ewsandor/esplant/README.md

# ESPlant

Ed Sandor's Plant Monitor based on an ESP 32 processor
