ewsandor/esplant/pcb/ESPlant.kicad_pcb

## KiCad design pcb/ESPlant.kicad_pcb (2020-08-11)

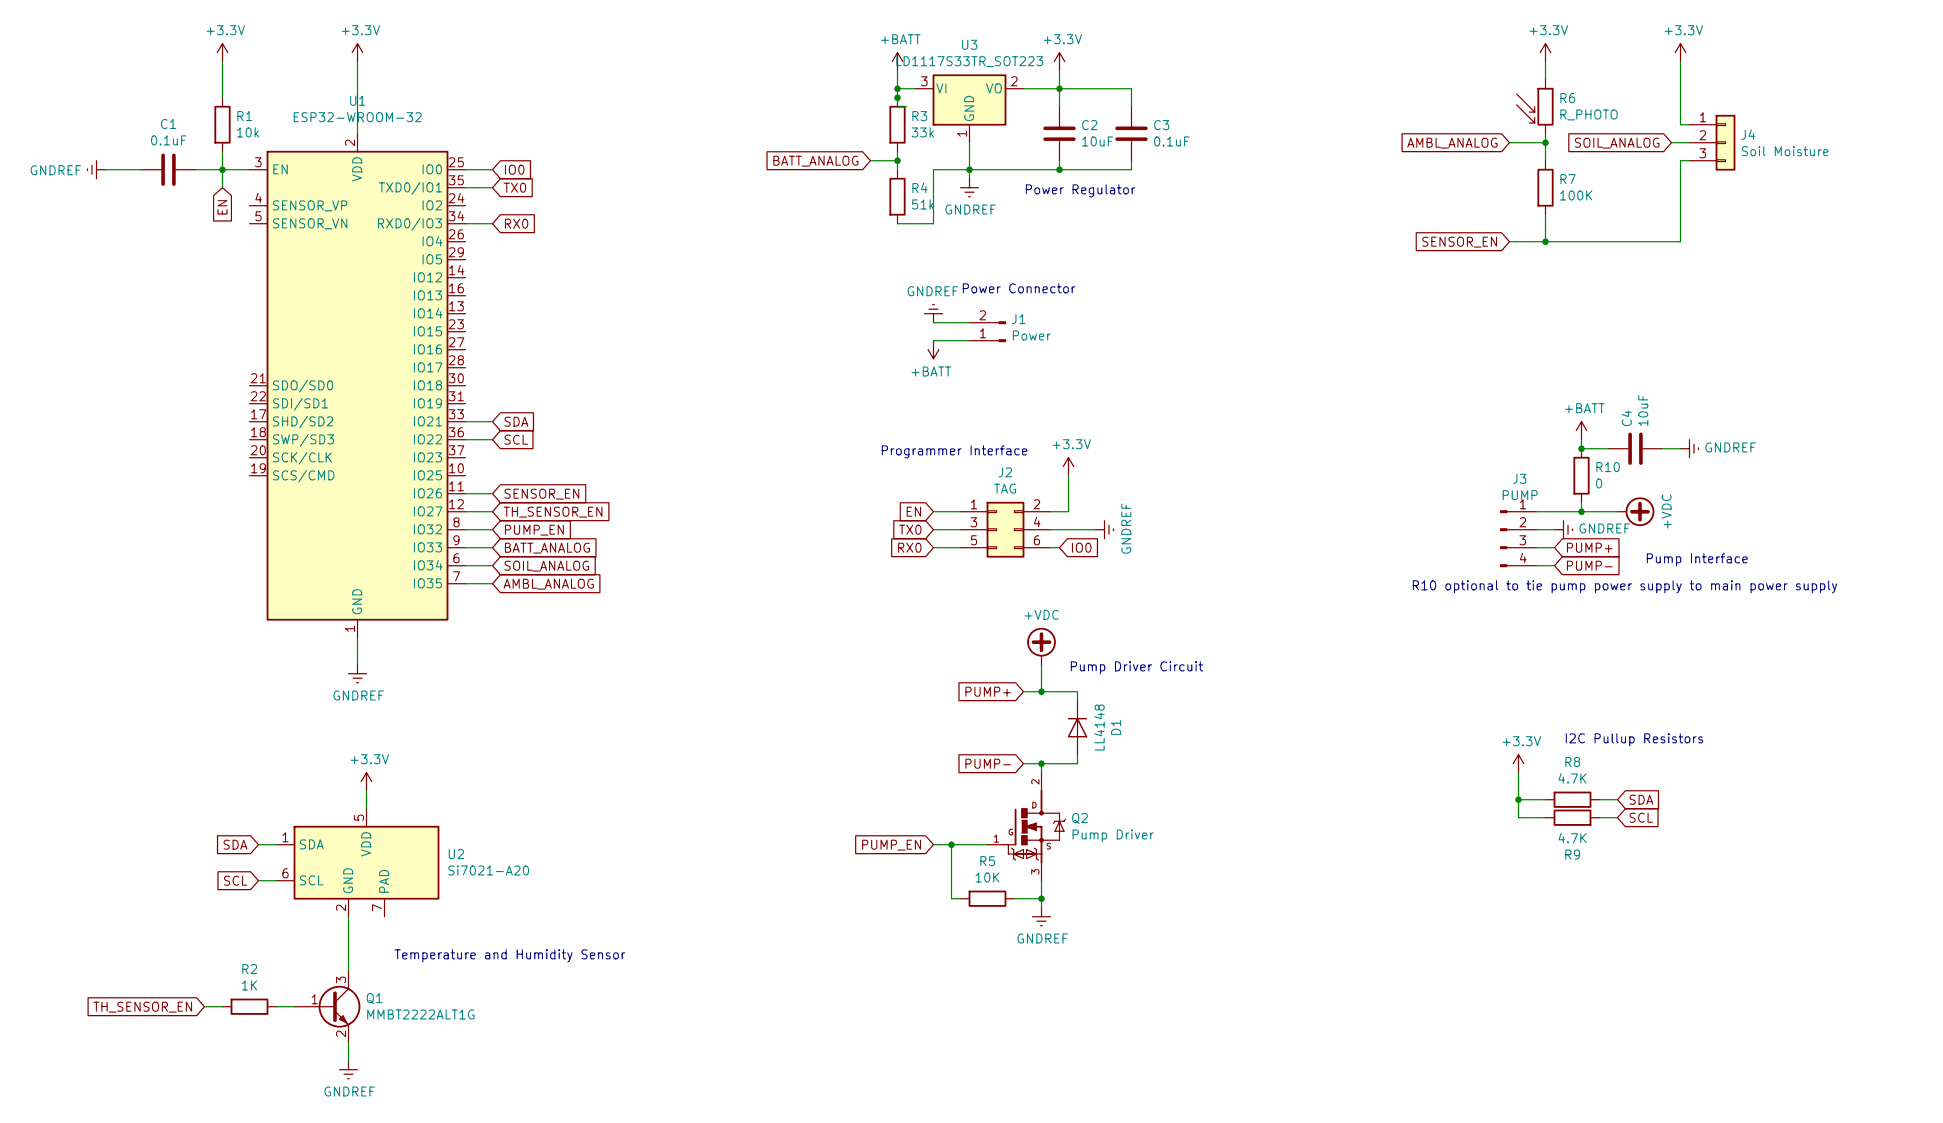
[picture p1: schematic ESPlant.sch]

Parts:
C1, C3: 0.1uF; C_0603_1608Metric_Pad1.05x0.95mm_HandSolder
C2, C4: 10uF; C_0603_1608Metric_Pad1.05x0.95mm_HandSolder
D1: LL4148; D_MiniMELF
J1: Power; PinHeader_1x02_P2.54mm_Vertical
J2: TAG; Tag-Connect_TC2030-IDC-NL_2x03_P1.27mm_Vertical
J3: PUMP; PinHeader_1x04_P2.54mm_Vertical
J4: Soil Moisture; PinHeader_1x03_P2.54mm_Vertical
Q1: MMBT2222ALT1G; SOT-23_Handsoldering
Q2: Pump Driver; TRANS_RFP30N06LE
R1: 10k; R_0603_1608Metric_Pad1.05x0.95mm_HandSolder
R2: 1K; R_0603_1608Metric_Pad1.05x0.95mm_HandSolder
R3: 33k; R_0603_1608Metric_Pad1.05x0.95mm_HandSolder
R4: 51k; R_0603_1608Metric_Pad1.05x0.95mm_HandSolder
R5: 10K; R_0603_1608Metric_Pad1.05x0.95mm_HandSolder
R6: R_PHOTO; R_LDR_5.1x4.3mm_P3.4mm_Vertical
R7: 100K; R_0603_1608Metric_Pad1.05x0.95mm_HandSolder
R8, R9: 4.7K; R_0603_1608Metric_Pad1.05x0.95mm_HandSolder
R10: 0; R_0603_1608Metric_Pad1.05x0.95mm_HandSolder
U1: ESP32-WROOM-32
U2: Si7021-A20; DFN-6-1EP_3x3mm_P1mm_EP1.5x2.4mm
U3: LD1117S33TR_SOT223; SOT-223-3_TabPin2

Connections:
+3V3: C2.1, C3.1, J2.2, J4.1, R1.1, R6.1, R8.2, R9.1, U1.2 (VDD), U2.5 (VDD), U3.2 (VO)
+BATT: C4.1, J1.1, R3.1, R10.1, U3.3 (VI)
AMBL_ANALOG: R6.2, R7.1, U1.7 (IO35)
BATT_ANALOG: R3.2, R4.1, U1.9 (IO33)
EN: C1.1, J2.1, R1.2, U1.3 (EN)
GNDREF: C1.2, C2.2, C3.2, C4.2, J1.2, J2.4, J3.2, Q1.2 (E), Q2.3 (S), R4.2, R5.1, U1.1 (GND), U1.15 (GND), U1.38 (GND), U1.39 (GND), U3.1 (GND)
IO0: J2.6, U1.25 (IO0)
unnamed: Q1.1 (B), R2.1
unnamed: Q1.3 (C), U2.2 (GND)
PUMP+: D1.1 (K), J3.1, J3.3, R10.2
PUMP-: D1.2 (A), J3.4, Q2.2 (D)
PUMP_EN: Q2.1 (G), R5.2, U1.8 (IO32)
RX0: J2.5, U1.34 (RXD0/IO3)
SCL: R9.2, U1.36 (IO22), U2.6 (SCL)
SDA: R8.1, U1.33 (IO21), U2.1 (SDA)
SENSOR_EN: J4.3, R7.2, U1.11 (IO26)
SOIL_ANALOG: J4.2, U1.6 (IO34)
TH_SENSOR_EN: R2.2, U1.12 (IO27)
TX0: J2.3, U1.35 (TXD0/IO1)

Notes on the sheet:
Temperature and Humidity Sensor
Power Regulator
Pump Interface
R10 optional to tie pump power supply to main power supply
Power Connector
Programmer Interface
Pump Driver Circuit
I2C Pullup Resistors

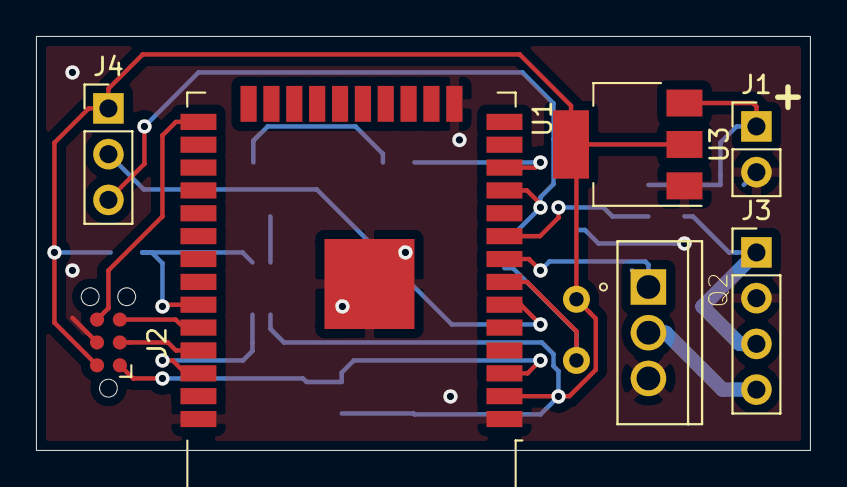
[picture p2: board ESPlant.kicad_pcb from above]

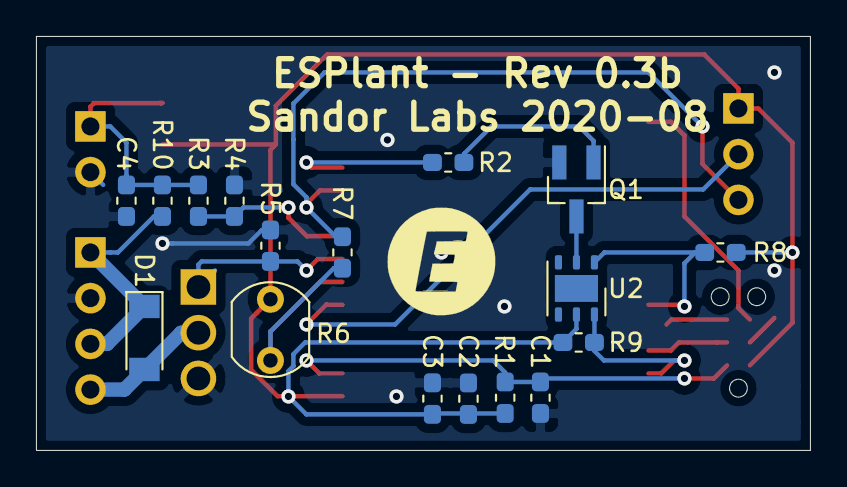
[picture p3: board ESPlant.kicad_pcb from below]

Board: 2 copper layers, 43.0 x 23.0 mm, 24 parts (17 on the bottom side), 19 nets.
