ewsandor/esplant/(commit log)

2020-02-29 Initial checkin of project files as is
    [ESPlant.kicad_pcb, ESPlant.sch]
2020-02-29 Moving kicad files to PCB directory
    [ESPlant.kicad_pcb, ESPlant.sch]
2020-03-01 Updating sensor enable/disable schematic. FIrst attempt at board layout
2020-03-07 Increase with of pump traces to support 1A
    [ESPlant.kicad_pcb]
2020-03-08 Official revision 0.1! Adding revision info and logo to PCB
    [ESPlant.kicad_pcb, ESPlant.sch]
2020-03-10 PCB Revision 0.2 fixing Q1 footprint from NPN BCE to BEC to match more common parts. Minor routing revisions
    [ESPlant.kicad_pcb, ESPlant.sch]
2020-03-10 Silkscreen cleanup
    [ESPlant.kicad_pcb]
2020-03-29 Initial ESPlant Arduino based software. Updated battery voltage divider values in schematic.
    [ESPlant.sch]
2020-08-11 Flipping batter positive and negative pins and added '+' symbol to resolve ambiguity during assembly
    [ESPlant.kicad_pcb, ESPlant.sch]
